AteamVentures/Creatable_D2/README.md

# Creatable D2
Creatable D2는 Reprep기반의 델타방식의 3D프린터입니다.

폴더 설명

 - Hardware : 회도로 및 PCB 파일 (Mainboard는 Cadence의 Allegro로 작업이되어 있고 나머지는 Eagle CAD로 작업)
 - Firmware : 메인 보드 ATmega2560 firmware
 - 16U2 : 메인 보드 Atmega16U2 firmware
 - stk500v2 : 메인 보드 ATmega2560 bootloader
