AteamVentures/Creatable_D2/Hardware/MainBoard/Mainboard_Sch.pdf

## Thermistors

## E0-MOT

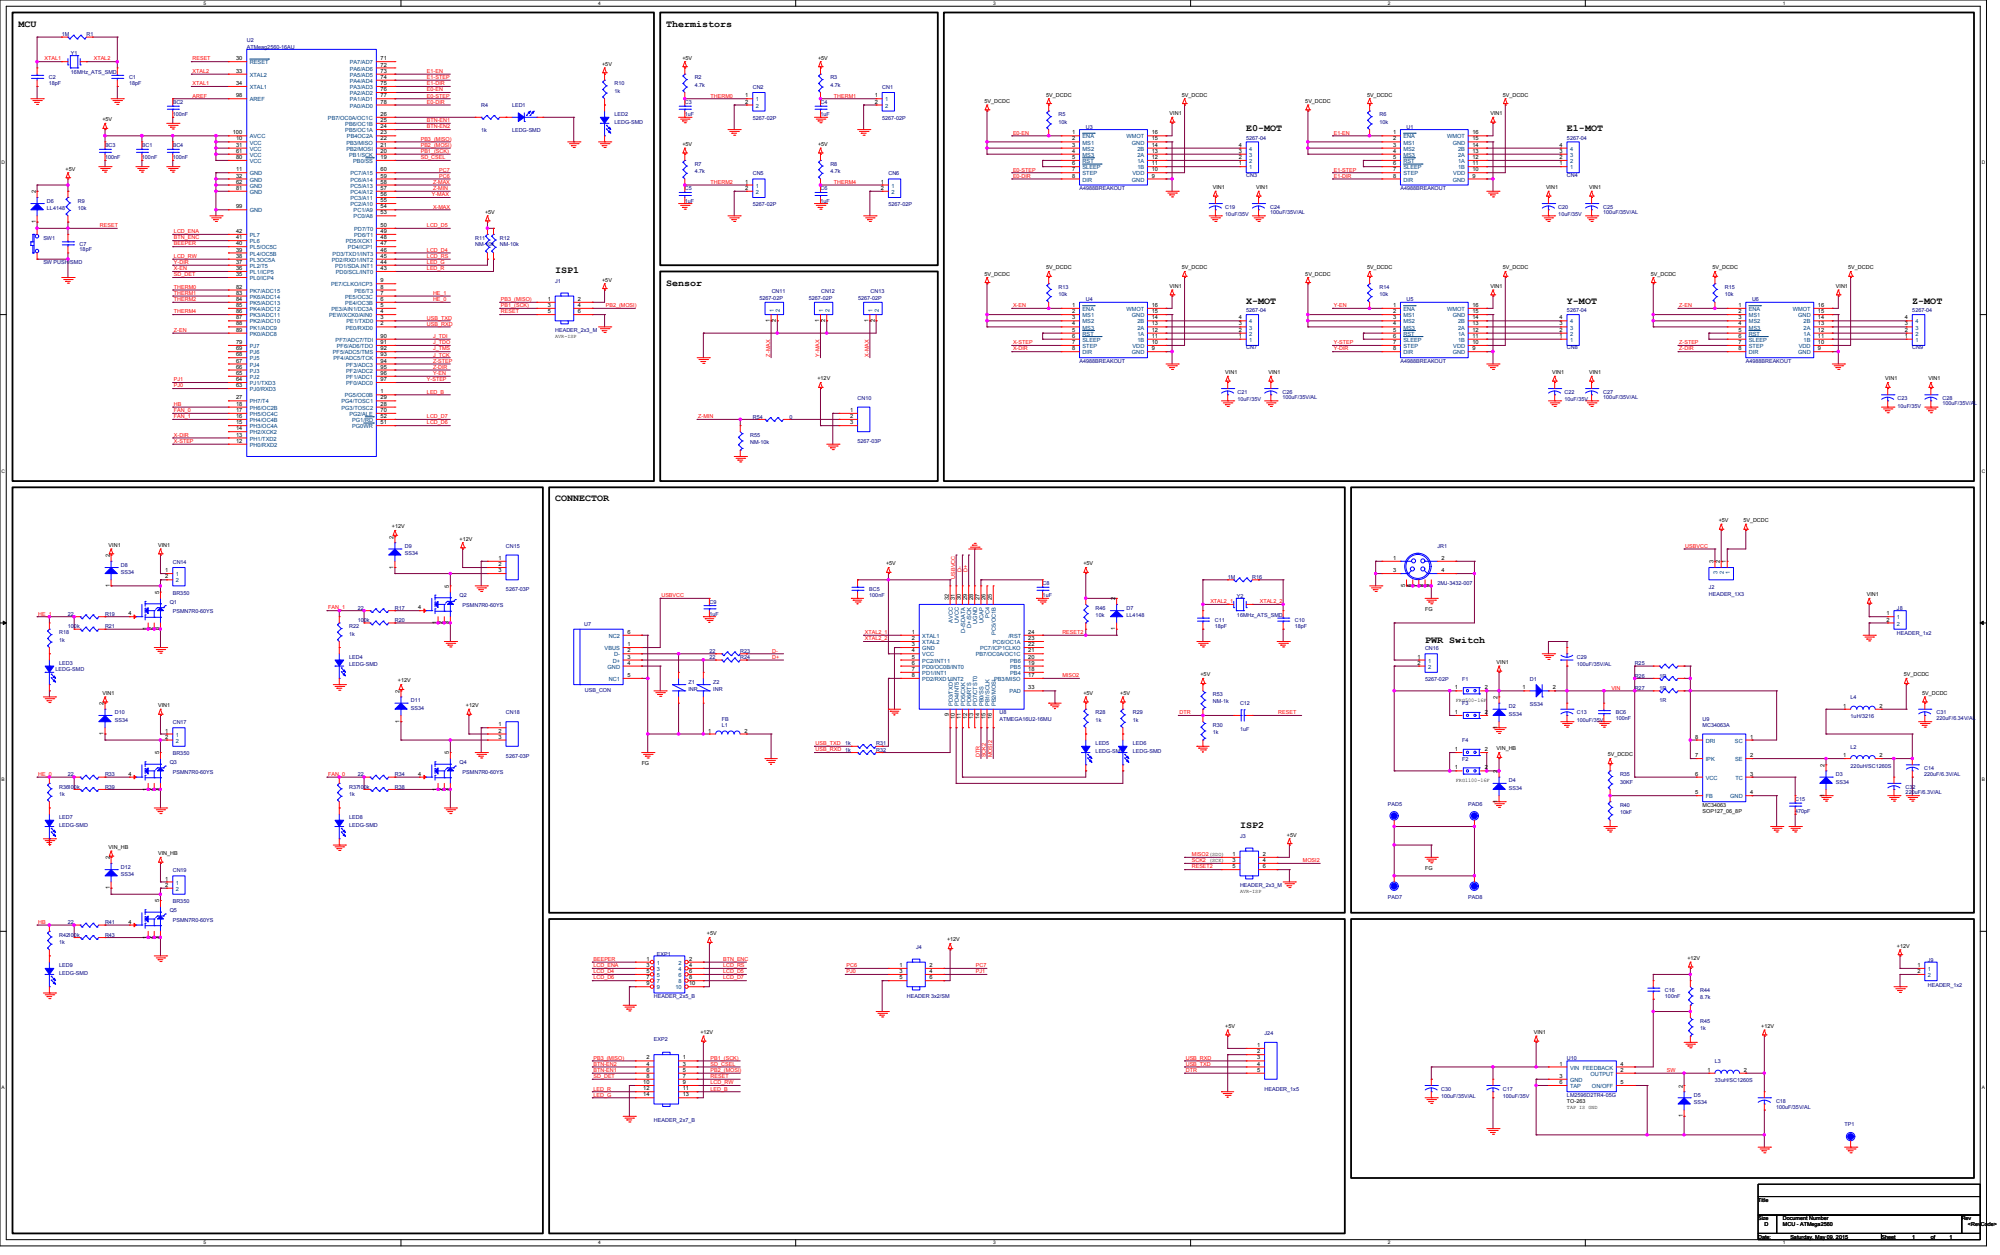
[picture p3: page 1]

SD_CSEL PB1_(SCK) PB2_(MOSI) PB3_(MISO) BTN-EN2 BTN-EN1

9 PD4/INT5 10 PD5/CXK 11 PD6/RTS 12 PD7/CTST0 13 PB0/SS 14 PB1/SCLK 15 PB2/MOSI 16
