AteamVentures/Creatable_D2/(list of files, drawings)

Other design files:
Hardware/MainBoard/Mainboard_Sch_0816.DSN
