AteamVentures/Creatable_D2/Hardware/OLED/OLED.brd

## EAGLE design Hardware/OLED/OLED.brd (2016-01-15)

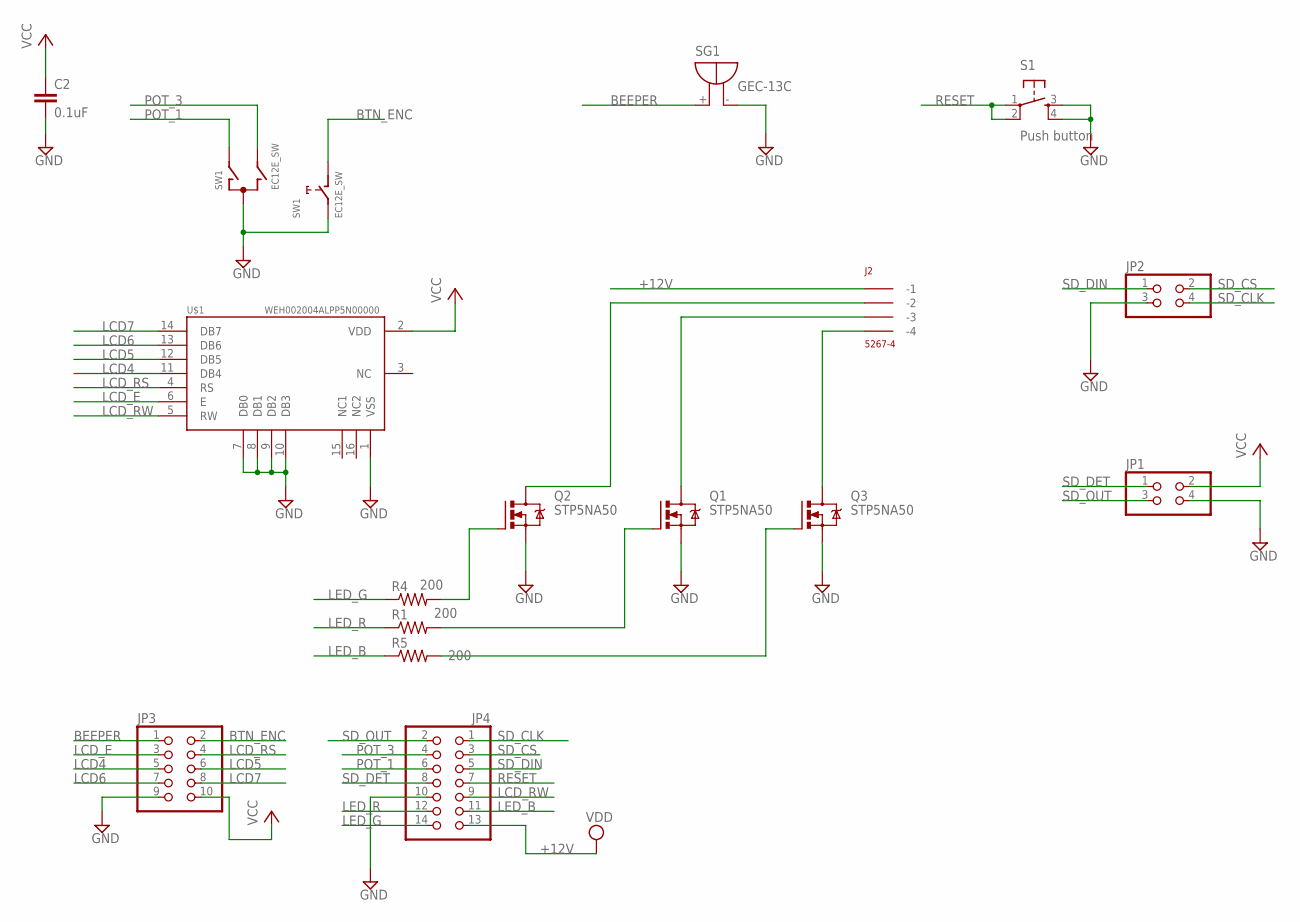
[picture p4: schematic OLED.sch]

Parts:
C2: 0.1uF; C0805
J2: 5267-4
JP1, JP2: PINHD-2X2; 2X02
JP3: PINHD-2X5/90; 2X05/90
JP4: PINHD-2X7/90; 2X07/90
Q1, Q2, Q3: STP5NA50; TO220BV
R1, R4, R5: 200; R2012
S1: Push button; TACTILE-PTH
SG1: GEC-13C; F/TMB
SW1: EC12E_SW; ALPS_EC12E_SW
U$1: OLED; WEH002004ALPP5N00000

Connections:
+12V: J2.P$1 (-1), JP4.13
BEEPER: JP3.1, SG1.+
BTN_ENC: JP3.2, SW1.D (1)
GND: C2.2, JP1.4, JP2.3, JP3.9, JP4.10, Q1.S, Q2.S, Q3.S, S1.3, S1.4, SG1.-, SW1.C, SW1.E (2), U$1.1 (VSS), U$1.7 (DB0), U$1.8 (DB1), U$1.9 (DB2), U$1.10 (DB3)
LCD4: JP3.5, U$1.11 (DB4)
LCD5: JP3.6, U$1.12 (DB5)
LCD6: JP3.7, U$1.13 (DB6)
LCD7: JP3.8, U$1.14 (DB7)
LCD_E: JP3.3, U$1.6 (E)
LCD_RS: JP3.4, U$1.4 (RS)
LCD_RW: JP4.9, U$1.5 (RW)
LED_B: JP4.11, R5.1
LED_G: JP4.14, R4.1
LED_R: JP4.12, R1.1
unnamed: Q2.G, R4.2
unnamed: Q1.G, R1.2
unnamed: Q3.G, R5.2
unnamed: J2.P$2 (-2), Q2.D
unnamed: J2.P$3 (-3), Q1.D
unnamed: J2.P$4 (-4), Q3.D
POT_1: JP4.6, SW1.A
POT_3: JP4.4, SW1.B
RESET: JP4.7, S1.1, S1.2
SD_CLK: JP2.4, JP4.1
SD_CS: JP2.2, JP4.3
SD_DET: JP1.1, JP4.8
SD_DIN: JP2.1, JP4.5
SD_OUT: JP1.3, JP4.2
VCC: C2.1, JP1.2, JP3.10, U$1.2 (VDD)

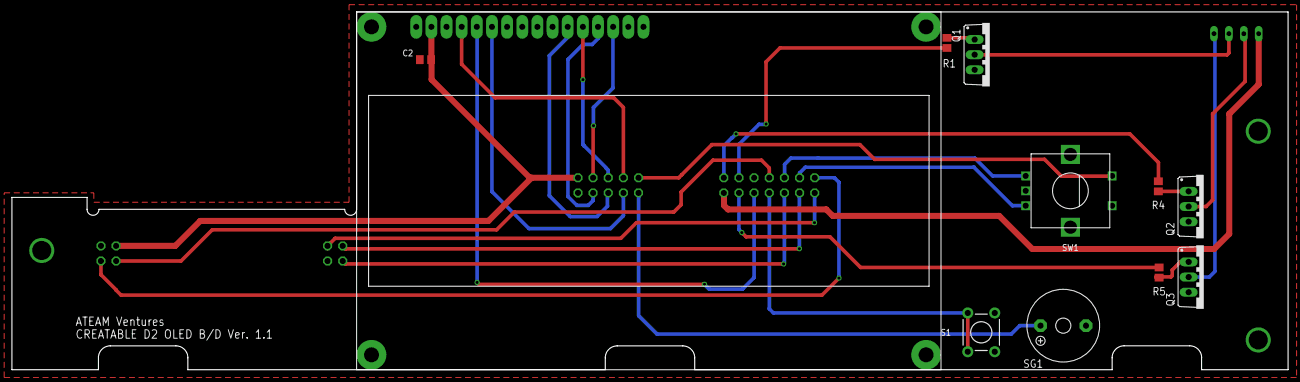
[picture p5: board OLED.brd from above]

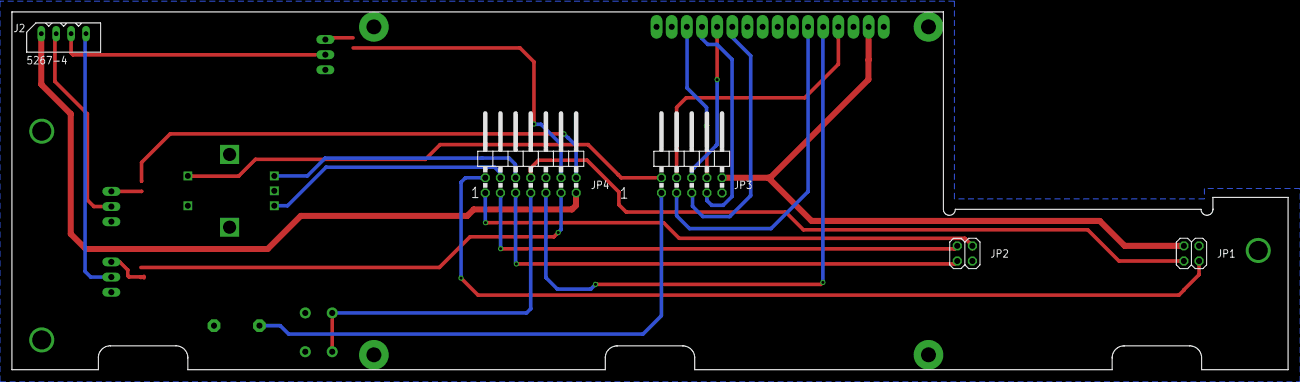
[picture p6: board OLED.brd from below]

Board: 2 copper layers, 214.0 x 60.0 mm, 16 parts (5 on the bottom side), 29 nets.
