AteamVentures/Creatable_D2/Hardware/SD/SD.brd

## EAGLE design Hardware/SD/SD.brd (2016-01-15)

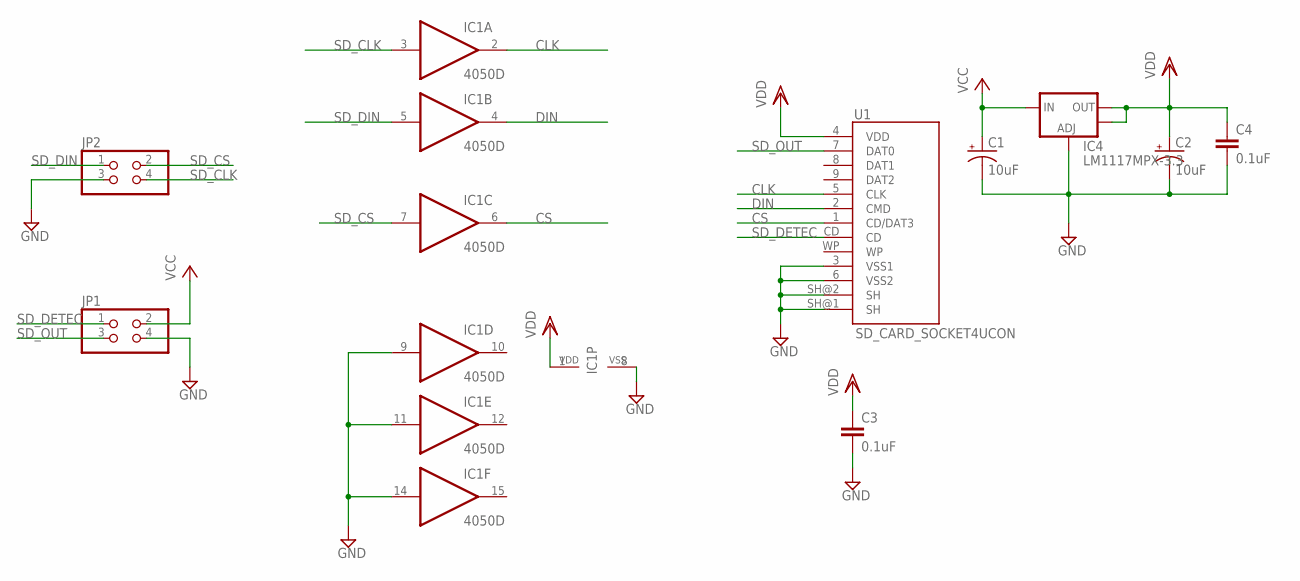
[picture p7: schematic SD.sch]

Parts:
C1, C2: 10uF; CT3216
C3, C4: 0.1uF; C0805
IC1: 4050D; SO16
IC4: LM1117MPX-3.3; SOT223
JP1, JP2: PINHD-2X2; 2X02
U1: SD_CARD_SOCKET4UCON; SDCARD_4UCONN

Connections:
CLK: IC1.2 (O), U1.5 (CLK)
CS: IC1.6 (O), U1.1 (CD/DAT3)
DIN: IC1.4 (O), U1.2 (CMD)
GND: C1.-, C2.-, C3.2, C4.2, IC1.8 (VSS), IC1.9 (I), IC1.11 (I), IC1.14 (I), IC4.1 (ADJ), JP1.4, JP2.3, U1.3 (VSS1), U1.6 (VSS2), U1.SH@1 (SH), U1.SH@2 (SH)
SD_CLK: IC1.3 (I), JP2.4
SD_CS: IC1.7 (I), JP2.2
SD_DETEC: JP1.1, U1.CD
SD_DIN: IC1.5 (I), JP2.1
SD_OUT: JP1.3, U1.7 (DAT0)
VCC: C1.+, IC4.3 (IN), JP1.2
VDD: C2.+, C3.1, C4.1, IC1.1 (VDD), IC4.2 (OUT), IC4.4 (OUT), U1.4 (VDD)

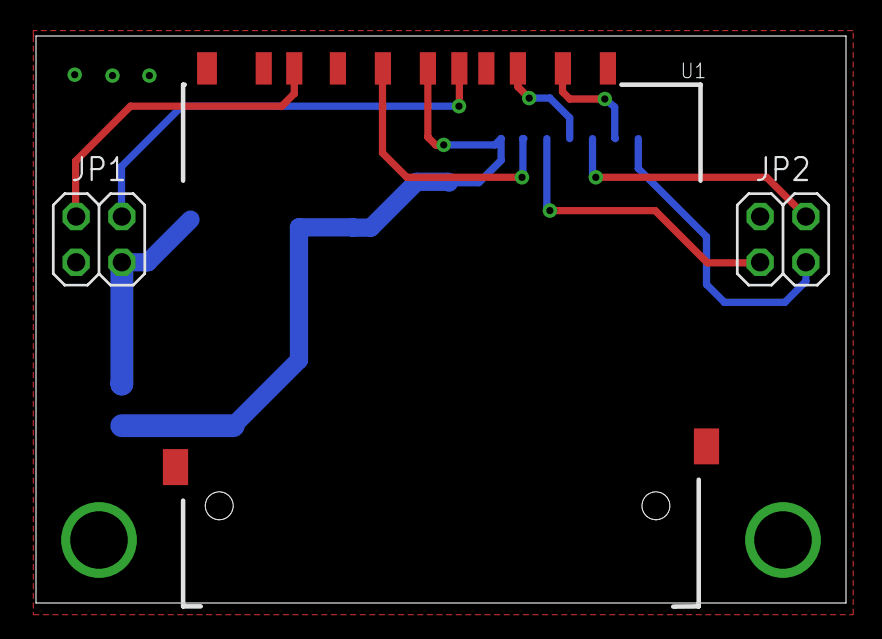
[picture p8: board SD.brd from above]

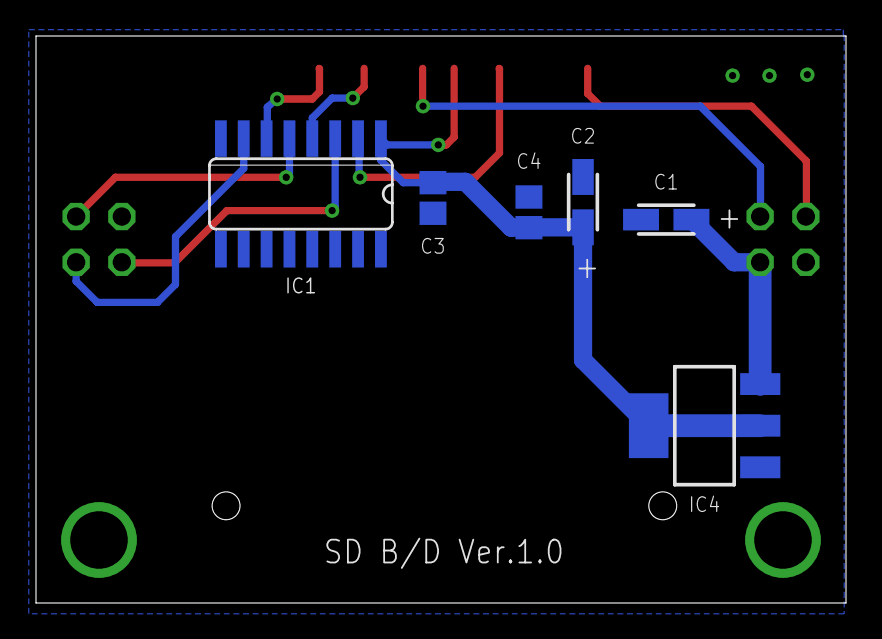
[picture p9: board SD.brd from below]

Board: 2 copper layers, 45.0 x 31.5 mm, 9 parts (6 on the bottom side), 11 nets.
