AteamVentures/Creatable_D2/Firmware/Marlin/Firmware Change History..txt

Firmware Change History

Ver. 1.0.5
-. Add filament selecting option in Extrude filament menu
-. Increase the Z resolution value when setting the Z-offset
-. Reduce the BLOCK_BUFFER_SIZE size from 16 to 4 : minimizing lack when operate the LCD panel
-. Debug: bed_level variale when the index is bigger than 3
-. Add 5x5 probing code (Not deploy in 1.0.5) - uncomment LEVELING_ALL_PROBE in Configuration.h

Ver. 1.0.4
-. Reset to default - Reset Z offset value
-. Change DEFAULT_EJERK, DEFAULT_MAX_ACCELERATION, DEFAULT_ACCELERATION
-. Extrude filament - Fan on 
-. Z Raise +10
-. Automatically Fan control according to the temp
-. Set Z offset limit
-. Apply 4 point autoleveling
