AteamVentures/Creatable_D2/Firmware/Marlin/Configuration.h

#define CONFIGURATION_H
#define STRING_VERSION_CONFIG_H __DATE__ " " __TIME__ // build date and time
#define STRING_CONFIG_H_AUTHOR "Version 1.0.6" // Who made the changes.
#define SERIAL_PORT 0
#define BAUDRATE 250000
#define OLED
#define LED_STRIP
#define FILAMENT_LOAD_TEMP          220
#define FILAMENT_UNLOAD_LEN         700
#define FILAMENT_LOAD_LEN           600  //
#define FILAMENT_LOAD_LEN2          100  //
#define FILAMENT_UNLOAD_SPEED       200
#define FILAMENT_LOAD_SPEED         200
#define FILAMENT_MOVE_ACCELERATION   30
#ifdef TEST     // Not used
#define LEVELING_TEMP 200
#endif
#define MOTHERBOARD 80
#define EXTRUDERS 1
#define POWER_SUPPLY 1
#define DELTA
#define DELTA_SEGMENTS_PER_SECOND 200
#define DELTA_DIAGONAL_ROD 245 // mm
#define DELTA_SMOOTH_ROD_OFFSET 190.2 // mm
#define DELTA_EFFECTOR_OFFSET 27.9 // mm
#define DELTA_CARRIAGE_OFFSET 38 // mm
#define DELTA_RADIUS (DELTA_SMOOTH_ROD_OFFSET-DELTA_EFFECTOR_OFFSET-DELTA_CARRIAGE_OFFSET)
#define DELTA_PRINTABLE_RADIUS 100
#define SIN_60 0.8660254037844386
#define COS_60 0.5
#define DELTA_TOWER1_X -SIN_60*DELTA_RADIUS // front left tower
#define DELTA_TOWER1_Y -COS_60*DELTA_RADIUS
#define DELTA_TOWER2_X SIN_60*DELTA_RADIUS // front right tower
#define DELTA_TOWER2_Y -COS_60*DELTA_RADIUS
#define DELTA_TOWER3_X 0.0 // back middle tower
#define DELTA_TOWER3_Y DELTA_RADIUS
#define DELTA_DIAGONAL_ROD_2 pow(DELTA_DIAGONAL_ROD,2)
#define TEMP_SENSOR_0 1
#if EXTRUDERS > 1
  #define TEMP_SENSOR_1 1
#else
  #define TEMP_SENSOR_1 0
#endif
#define TEMP_SENSOR_2 0
#define TEMP_SENSOR_BED 8
#define MAX_REDUNDANT_TEMP_SENSOR_DIFF 10
#define TEMP_RESIDENCY_TIME 3  // (seconds)
#define TEMP_HYSTERESIS 3       // (degC) range of +/- temperatures considered "close" to the target one
#define TEMP_WINDOW     1       // (degC) Window around target to start the residency timer x degC early.
#define HEATER_0_MINTEMP 5
#define HEATER_1_MINTEMP 5
#define HEATER_2_MINTEMP 5
#define BED_MINTEMP 5
#define HEATER_0_MAXTEMP 275
#define HEATER_1_MAXTEMP 275
#define HEATER_2_MAXTEMP 275
#define BED_MAXTEMP 150
#define PIDTEMP
#define BANG_MAX 255 // limits current to nozzle while in bang-bang mode; 255=full current
#define PID_MAX 120 // limits current to nozzle while PID is active (see PID_FUNCTIONAL_RANGE below); 255=full current
  #define PID_FUNCTIONAL_RANGE 10 //10 // If the temperature difference between the target temperature and the actual temperature
  #define PID_INTEGRAL_DRIVE_MAX 255  //limit for the integral term
  #define K1 0.95 //smoothing factor within the PID
  #define PID_dT ((OVERSAMPLENR * 8.0)/(F_CPU / 64.0 / 256.0)) //sampling period of the temperature routine
    #define  DEFAULT_Kp 7.79
    #define  DEFAULT_Ki 0.35
    #define  DEFAULT_Kd 42.76
#define MAX_BED_POWER 255 // limits duty cycle to bed; 255=full current
#define EXTRUDE_MINTEMP 190
#define EXTRUDE_MAXLENGTH (X_MAX_LENGTH+Y_MAX_LENGTH) //prevent extrusion of very large distances.
#define ENDSTOPPULLUPS // Comment this out (using // at the start of the line) to disable the endstop pullup resistors
  #define ENDSTOPPULLUP_XMAX
  #define ENDSTOPPULLUP_YMAX
  #define ENDSTOPPULLUP_ZMAX
  #define ENDSTOPPULLUP_XMIN
  #define ENDSTOPPULLUP_YMIN
  #define ENDSTOPPULLUP_ZMIN
const bool X_MIN_ENDSTOP_INVERTING = false; // set to true to invert the logic of the endstop.
const bool Y_MIN_ENDSTOP_INVERTING = false; // set to true to invert the logic of the endstop.
const bool Z_MIN_ENDSTOP_INVERTING = true; // set to true to invert the logic of the endstop.
const bool X_MAX_ENDSTOP_INVERTING = false; // set to true to invert the logic of the endstop.
const bool Y_MAX_ENDSTOP_INVERTING = false; // set to true to invert the logic of the endstop.
const bool Z_MAX_ENDSTOP_INVERTING = false; // set to true to invert the logic of the endstop.
#if defined(COREXY) && !defined(DISABLE_MAX_ENDSTOPS)
  #define DISABLE_MAX_ENDSTOPS
#endif
#define X_ENABLE_ON 0
#define Y_ENABLE_ON 0
#define Z_ENABLE_ON 0
#define E_ENABLE_ON 0 // For all extruders
#define DISABLE_X false
#define DISABLE_Y false
#define DISABLE_Z false
#define DISABLE_E false // For all extruders
#define INVERT_X_DIR false    // for Mendel set to false, for Orca set to true
#define INVERT_Y_DIR false    // for Mendel set to true, for Orca set to false
#define INVERT_Z_DIR false    // for Mendel set to false, for Orca set to true
#define INVERT_E0_DIR true    // for direct drive extruder v9 set to true, for geared extruder set to false
#define INVERT_E1_DIR false   // for direct drive extruder v9 set to true, for geared extruder set to false
#define INVERT_E2_DIR false   // for direct drive extruder v9 set to true, for geared extruder set to false
#define X_HOME_DIR 1
#define Y_HOME_DIR 1
#define Z_HOME_DIR 1
#define min_software_endstops false // If true, axis won't move to coordinates less than HOME_POS.
#define max_software_endstops true  // If true, axis won't move to coordinates greater than the defined lengths below.
#define X_MAX_POS DELTA_PRINTABLE_RADIUS
#define X_MIN_POS -DELTA_PRINTABLE_RADIUS
#define Y_MAX_POS DELTA_PRINTABLE_RADIUS
#define Y_MIN_POS -DELTA_PRINTABLE_RADIUS
#define Z_MAX_POS MANUAL_Z_HOME_POS
#define Z_MIN_POS 0
#define X_MAX_LENGTH (X_MAX_POS - X_MIN_POS)
#define Y_MAX_LENGTH (Y_MAX_POS - Y_MIN_POS)
#define Z_MAX_LENGTH (Z_MAX_POS - Z_MIN_POS)
#define ENABLE_AUTO_BED_LEVELING // Delete the comment to enable (remove // at the start of the line)
#define OFFSET 0 // 85
 #define DELTA_PROBABLE_RADIUS (DELTA_PRINTABLE_RADIUS - 26)
  #define LEFT_PROBE_BED_POSITION -(DELTA_PROBABLE_RADIUS - OFFSET)
  #define RIGHT_PROBE_BED_POSITION (DELTA_PROBABLE_RADIUS - OFFSET)
  #define BACK_PROBE_BED_POSITION (DELTA_PROBABLE_RADIUS - OFFSET)
  #define FRONT_PROBE_BED_POSITION -(DELTA_PROBABLE_RADIUS -OFFSET)
  #define X_PROBE_OFFSET_FROM_EXTRUDER 0.0
  #define Y_PROBE_OFFSET_FROM_EXTRUDER 0.0
  #define Z_PROBE_OFFSET_FROM_EXTRUDER 0.35// Increase this if the first layer is too thin. This decreases gap about film thickness
  #define Z_RAISE_BEFORE_HOMING 4       // (in mm) Raise Z before homing (G28) for Probe Clearance.
  #define XY_TRAVEL_SPEED 4000         // X and Y axis travel speed between probes, in mm/min
  #define Z_RAISE_BEFORE_PROBING   50  //How much the extruder will be raised before traveling to the first probing point.
  #define Z_RAISE_BETWEEN_PROBINGS 50  //How much the extruder will be raised when traveling from between next probing points
  #define Z_RAISE_AFTER_PROBING 60  //How much the extruder will be raised after the last probing point.
  #define Z_SAFE_HOMING   // This feature is meant to avoid Z homing with probe outside the bed area.
    #define Z_SAFE_HOMING_X_POINT (X_MAX_LENGTH/2)    // X point for Z homing when homing all axis (G28)
    #define Z_SAFE_HOMING_Y_POINT (Y_MAX_LENGTH/2)    // Y point for Z homing when homing all axis (G28)
  #define ACCURATE_BED_LEVELING
    #define ACCURATE_BED_LEVELING_POINTS 3
    #define ACCURATE_BED_LEVELING_GRID_X ((RIGHT_PROBE_BED_POSITION - LEFT_PROBE_BED_POSITION) / (ACCURATE_BED_LEVELING_POINTS - 1))
    #define ACCURATE_BED_LEVELING_GRID_Y ((BACK_PROBE_BED_POSITION - FRONT_PROBE_BED_POSITION) / (ACCURATE_BED_LEVELING_POINTS - 1))
    #define NONLINEAR_BED_LEVELING
#define MANUAL_HOME_POSITIONS  // If defined, MANUAL_*_HOME_POS below will be used
#define BED_CENTER_AT_0_0  // If defined, the center of the bed is at (X=0, Y=0)
#define MANUAL_X_HOME_POS 0
#define MANUAL_Y_HOME_POS 0
#define MANUAL_Z_HOME_POS 163// 163 for Tefron 8t magnet, 170 for 4t donut magnet  //175  // For delta: Distance between nozzle and print surface after homing.
#define NUM_AXIS 4 // The axis order in all axis related arrays is X, Y, Z, E
#define HOMING_FEEDRATE {150*60, 150*60, 150*60, 0}  // set the homing speeds (mm/min)
#define XYZ_FULL_STEPS_PER_ROTATION 200
#define XYZ_MICROSTEPS 16
#define XYZ_BELT_PITCH 2
#define XYZ_PULLEY_TEETH 20       // This will be changed into 20 teeth
#define XYZ_STEPS (XYZ_FULL_STEPS_PER_ROTATION * XYZ_MICROSTEPS / double(XYZ_BELT_PITCH) / double(XYZ_PULLEY_TEETH))
#define DEFAULT_AXIS_STEPS_PER_UNIT   {XYZ_STEPS, XYZ_STEPS, XYZ_STEPS, 91.13}  // 17HS24-2104S
#define DEFAULT_MAX_FEEDRATE          {300, 300, 300, 45}    // (mm/sec)
#define DEFAULT_MAX_ACCELERATION      {5000,5000,5000,9000}    // X, Y, Z, E maximum start speed for accelerated moves. E default values are good for skeinforge 40+, for older versions raise them a lot.
#define DEFAULT_ACCELERATION          1000    // X, Y, Z and E max acceleration in mm/s^2 for printing moves
#define DEFAULT_RETRACT_ACCELERATION  3000   // X, Y, Z and E max acceleration in mm/s^2 for retracts
#define DEFAULT_XYJERK                20.0    // (mm/sec)
#define DEFAULT_ZJERK                 20.0    // (mm/sec)
#define DEFAULT_EJERK                 15.0    // (mm/sec)
#define EEPROM_SETTINGS
#define PLA_PREHEAT_HOTEND_TEMP 200
#define PLA_PREHEAT_HPB_TEMP 70
#define PLA_PREHEAT_FAN_SPEED 255   // Insert Value between 0 and 255
#define ABS_PREHEAT_HOTEND_TEMP 240
#define ABS_PREHEAT_HPB_TEMP 90
#define ABS_PREHEAT_FAN_SPEED 255   // Insert Value between 0 and 255
#define SDSUPPORT // Enable SD Card Support in Hardware Console
#define REPRAP_DISCOUNT_SMART_CONTROLLER
 #define ULTIPANEL
 #define NEWPANEL
  #define SDSUPPORT
  #define ULTRA_LCD
    #define LCD_WIDTH 20  // right here..
    #define LCD_HEIGHT 4
#define SOFT_PWM_SCALE 0
#include "Configuration_adv.h"
#include "thermistortables.h"
#define ENABLE_Z_OFFSET
